learnsometing/reaver-titan-build/kicad/reaver-titan-lighting.kicad_pcb

## KiCad design Tutorial/Tutorial.kicad_sch

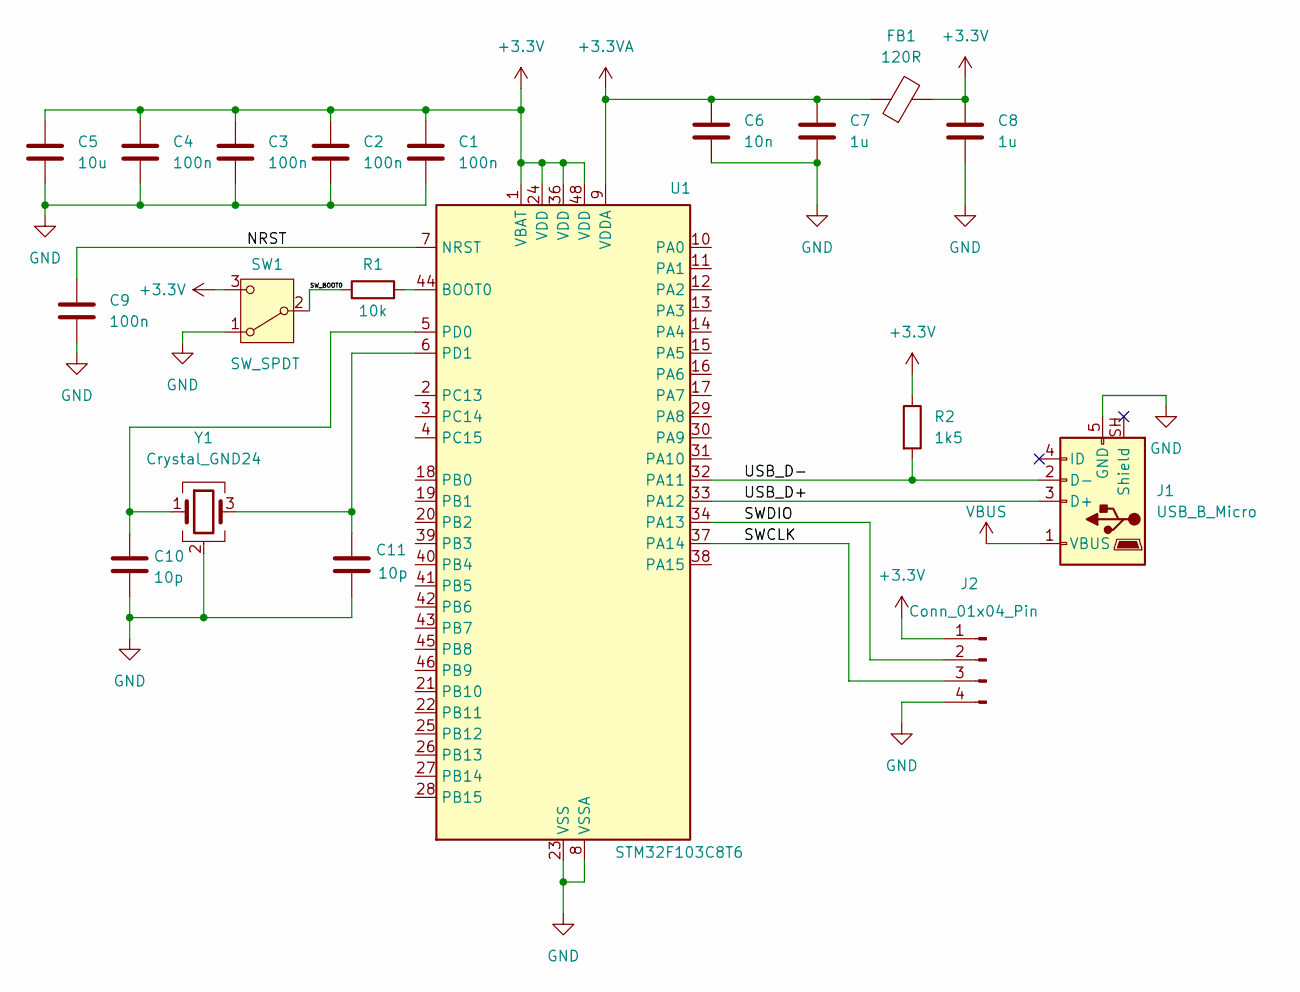
[picture p1: schematic Tutorial.kicad_sch]

Parts:
C1, C2, C3, C4, C9: 100n; SOIC-8_3.9x4.9mm_P1.27mm
C5: 10u; SOIC-8_3.9x4.9mm_P1.27mm
C6: 10n
C7, C8: 1u
C10, C11: 10p; SOIC-8_3.9x4.9mm_P1.27mm
FB1: 120R; BeagleBoard_PocketBeagle
J1: USB_B_Micro
J2: Conn_01x04_Pin
R1: 10k
R2: 1k5
SW1: SW_SPDT; SW_NKK_GW12LJP
U1: STM32F103C8T6; LQFP-48_7x7mm_P0.5mm
Y1: Crystal_GND24; Crystal_SMD_3225-4Pin_3.2x2.5mm

Connections:
+3.3V: C1.1, C2.1, C3.1, C4.1, C5.1, C8.1, FB1.2, J2.1, R2.1, SW1.3 (C), U1.1 (VBAT), U1.24 (VDD), U1.36 (VDD), U1.48 (VDD)
+3.3VA: C6.1, C7.1, FB1.1, U1.9 (VDDA)
GND: C1.2, C2.2, C3.2, C4.2, C5.2, C6.2, C7.2, C8.2, C9.2, C10.2, C11.2, J1.5 (GND), J2.4, SW1.1 (A), U1.8 (VSSA), U1.23 (VSS), U1.35 (VSS), U1.47 (VSS), Y1.2 (G), Y1.4 (G)
NRST: C9.1, U1.7 (NRST)
unnamed: C10.1, U1.5 (PD0), Y1.1
unnamed: C11.1, U1.6 (PD1), Y1.3
unnamed: R1.2, U1.44 (BOOT0)
SWCLK: J2.3, U1.37 (PA14)
SWDIO: J2.2, U1.34 (PA13)
SW_BOOT0: R1.1, SW1.2 (B)
USB_D+: J1.3 (D+), U1.33 (PA12)
USB_D-: J1.2 (D-), R2.2, U1.32 (PA11)
VBUS: J1.1 (VBUS)
