learnsometing/reaver-titan-build/firmware/step-a2-i2c-scan/step-a2-i2c-scan.ino

#include <Wire.h>

void setup() {
  Serial.begin(115200);
  delay(1000);
  Wire.begin(8, 9);
  Serial.println("Scanning I2C bus...");

  for (byte address = 1; address < 127; address++) {
    Wire.beginTransmission(address);
    byte error = Wire.endTransmission();

    if (error == 0) {
      Serial.print("Device found at address 0x");
      if (address < 16) Serial.print("0");
      Serial.println(address, HEX);
    }
  }
  Serial.println("Scan complete.");
}

void loop() {
}
