learnsometing/reaver-titan-build/(commit log)

2026-04-18 chore: initial commit
    [reaver-titan-lighting.kicad_pcb, reaver-titan-lighting.kicad_sch]
2026-04-18 chore: remove kicad history submodule
2026-04-20 chore: migrate build roadmap to GitHub Project (#19)
    Remove docs/build-roadmap.md and update README links to point to the
    Reaver Titan Build GitHub Project (issues #6–#18).
2026-04-20 docs: enhance existing documentation (#20)
    * chore: migrate build roadmap to GitHub Project
    * docs: enhance existing documentation
    - Replace power.md with core-infrastructure.md and build-guide.md
    - Replace ASCII/Mermaid diagrams with KiCad SVG placeholders
    - Remove redundant schematic references table from blaster.md
    - Update README docs table and remove stale electrical overview
    * docs: update core infrastructure BOM with order status
    Co-Authored-By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
2026-04-21 chore: ignore kicad lock, backup, and prl files; document PR workflow in CLAUDE.md (#24)
2026-04-21 feat: separate schematic into hierarchical sheets (#25)
    Split the flat reaver-titan-lighting.kicad_sch into a root navigation
    sheet with two hierarchical sub-sheets: core-power.kicad_sch and
    blaster-zones.kicad_sch. Cross-sheet PCA9685 channel signals use global
    labels (PCA_CH5–9). Consolidated versioned ERC reports into single ERC.rpt.
    Closes #22
    [blaster-zones.kicad_sch, core-power.kicad_sch, reaver-titan-lighting.kicad_sch]
2026-04-22 docs: rename schematic sheets and add SVG exports
    - Rename core-power.kicad_sch → core-infrastructure.kicad_sch
    - Rename blaster-zones.kicad_sch → blaster.kicad_sch
    - Export core-infrastructure.svg and blaster.svg from KiCad
    - Update SVG references in core-infrastructure.md and blaster.md
    - Update CLAUDE.md schematic table to reflect new filenames
    Closes #21
    [blaster.kicad_sch, core-infrastructure.kicad_sch, reaver-titan-lighting.kicad_sch]
2026-04-24 docs: expand build guide with breadboard prototype plan (#27)
    * docs: expand build guide with step-by-step breadboard prototype plan
    Each step includes wiring instructions and explicit pass/fail criteria.
    Steps 1-2 (power chain setup) are actionable now; steps 3-6 are marked
    as waiting on the ESP32-S3.
    * docs: update BMS status to Arrived in core infrastructure BOM
    * docs: simplify power chain — remove BMS, add low-voltage alarm
    - Remove BMS from power chain; battery internal protection is sufficient
    for this low-current display application
    - Add LiPo low-voltage alar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
    [core-infrastructure.kicad_sch]
2026-04-24 docs: mark all core infrastructure BOM items as arrived (#29)
    Balance charger, low-voltage alarm, and microcontroller have been
    received. All core infrastructure and blaster BOM items are now in hand.
    Closes #9
2026-04-24 docs: restructure Phase 1 into firmware and power chain tracks, add breadboard sketches (#30)
2026-04-26 docs: update wire gauge to 22 AWG throughout, mark Phase 1B complete (#31)
    All internal wiring uses 22 AWG — peak input current is ~1.75A and all
    runs are short enough that voltage drop is negligible. Only the pre-wired
    T-connector leads remain 14 AWG. Phase 1B steps B1 and B2 marked complete
    after confirming 5.06V buck output and switch operation.
2026-04-27 feat: firmware sketches, A2 wiring fix, Track C placeholder (#34)
    * feat: extract inline sketches to firmware directory and fix A2 wiring
    * feat: add Step A4 WiFi web UI sketch, Track C placeholder, and issue #33
    ---------
    [step-a2-i2c-scan.ino, step-a3-led-fade.ino]
2026-04-27 feat: track c nodejs UI (#35)
    * docs: add firmware/ui README with stack, constraints, zone map, and dev workflow
    * feat: scaffold Svelte/Vite UI, add Step A5 sketch with ui.h build workflow
    - Add Svelte + Vite project under firmware/ui/ with Dark Mechanicus terminal
    aesthetic (green phosphor on black, scanlines, glitch title animation)
    - Overview: head/torso zone toggles, brightness slider (0–4095), laser blaster
    weapon card; blaster detail view with IDLE/PRIME/FULL CHARGE/DISCHARGE states
    - Mock dev server stubs all ESP32 endpoints via Vite configureServer middleware
    - npm run ui:build bundles to single inlined HTML and gene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
    [step-a5-web-ui-svelte.ino]
2026-04-28 feat: track D MOSFET prototype (#36)
    * feat: track D MOSFET prototype — SOT-23 breakout, two-channel heatsink sketch
    - mark SOT-23 DIP breakout boards as arrived in blaster BOM
    - add track D to build guide (step D1 complete, step D2 heatsink prototype)
    - add step-d2 sketch: non-blocking state machine on CH6+CH7, served via Svelte UI
    * docs: mark step D2 complete, add step D3 full heatsink prototype
    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
2026-05-05 docs: flesh out all lighting zones, add arms and channel-map docs (#37)
    Add arms.md covering modular weapon socket architecture, 9-pin shoulder
    connector standard, weapon ID resistor detection, and arm pool channel
    allocation. Add channel-map.md with complete 16-channel PCA9685 reference.
    Update blaster.md, head.md, power-fist.md, and torso.md with full zone
    specs, electrical details, and cross-references to the new arm pool docs.
2026-05-06 feat: confirm blaster inline resistor values from bench measurements (#38)
    Bench measurements confirmed Vf ~2.77V for both rope lengths, with
    actual current of 303–310mA through 6.8Ω (not 72mA as previously
    documented — that measurement was taken without a MOSFET in circuit).
    Target brightness empirically set at 154mA per rope — validated on
    bench as the brightness sweet spot within the 3A buck converter budget
    for dual-blaster operation.
    Inline resistors move into the weapon arm (torso board stays
    weapon-agnostic): barrels 4.7Ω 2W, heatsink 13.6Ω (2× 6.8Ω in
    series) per zone across 5 zones.
    Add step-d3 measurement sketch and step-d4 two-channel brightness
    compare sketch with w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
2026-05-07 feat: blaster schematic update and heatsink sequence prototype (#39)
    * feat: add heatsink firing sequence prototype sketch (step-d5)
    * docs: update wire gauge to Kynar 28 AWG OFHC for all internal wiring
    * feat: update blaster schematic, channel map, and heatsink sequence
    - Reverse heatsink channel order: Ch 1 = front, Ch 5 = rear (reactor end)
    - Update blaster.kicad_sch: resistor values, channel labels, zone names
    - Regenerate blaster.svg and core-infrastructure.svg from KiCad
    - Update docs (blaster.md, channel-map.md, arms.md) to reflect new channel order
    - Update step-d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
    [blaster.kicad_sch, core-infrastructure.kicad_sch]
2026-05-08 docs: add full physical design specs and correct heatsink geometry
    Body dimensions (127mm cap-to-barrel-face), barrel physical design
    (helical core params, removable assembly with JST), and heatsink core
    redesign based on slicer measurements: bore D-shaped at 29.64mm,
    horseshoe core at 29mm OD with 3mm wall and fully open interior.
    Corrected cylinder OD (33.6mm at gaps, 31.6mm at extension) and
    core extension length (1.342mm). Upstream dim refs updated throughout.
2026-05-08 docs: record heatsink core prototype v1 validation and retention plan
    Confirmed fit, light transmission, and X-pattern rope end routing.
    Documents planned alternating arch/tab retention feature as next iteration.
2026-05-09 docs: document heatsink wiring harness and bench validation
    6-pin connector scheme (1x +5V trunk, 5x drain returns), construction
    order, resistor bundling notes, and bench confirmation of all 5 zones
    on Ch 1-5. Notes Ch 0 exclusion from step-d5 firmware.
